oldprize47-SH/AutonomousDrone/complementary-filter/docs/Complementary_Filter.pptx

Complementary Filer Design

Autonomous Vehicle Control

School of Mechanical and Control Engineering
22000561 Jeayong Lee / 22100149 Yejoon Kim
22100652 Sein Jeon / 22300510 Dawon Lee

## Contents

1. 용어정리
2. 목표
3. 고도채널 안정화 루프 분석
4. 기압고도계 설계
5. 고도채널 안정화 루프 설계
6. 결과 분석
7. 부록

## 1. 목표

INS만을 활용하여 구한 자율이동체의
위치는 시간이 지남에 따라 발산

보조항법장치(Barometer 등)에서 구한 자율이동체의 위치는 정확하나 응답이 느림

보조항법 센서를 활용하여
INS의 발산하는 특성을 보완 하자!

## 2. 용어정리

Symbol | Name | Value
H_p | 기압고도 | 구해야 하는 값 [m]
H_0 | 해당 대기층 하단부의 기준 고도 | 0 [m]
T_0 | H_0 에서의 온도 | 288.15 [K]
P | 특정 고도에서의 기압 | 센서 측정 값 [Pa]
P_0 | H_0 에서의 기압 | 101325 [Pa]
R^(∗) | 보편 기체 상수(universal gas constant) | 8.13446 [J/(mol⋅K)]
Γ | 대류층 온도 변화율 | 0.0065 [K/m]
g_0 | 해수면 기준 중력 가속도 | 9.78032677 [m/s^2 ]
M | 공기의 평균 분자량 | 0.0289644 [kg/mol]
Z | 기하학적 고도 차이 | H_p −H_0 [m]
ρ | 공기 밀도 | 계산 값 [kg/m^3 ]
ρ_0 | H_0 에서의 공기 밀도 | 1.225 [kg/m^3 ]

**비고 - 지역에 따라서 달라질 가능성 有, 추후 파라미터 변경 가능

**비고

**비고

IMU 센서 출력 값 기준으로 변경

9.80665 [m/s^2 ]

높이의 증분( dZ )으로부터
정의 됨

**비고

*상수 값은 ICAO 표준규격 기준

## 3. 고도채널 안정화 루프 분석

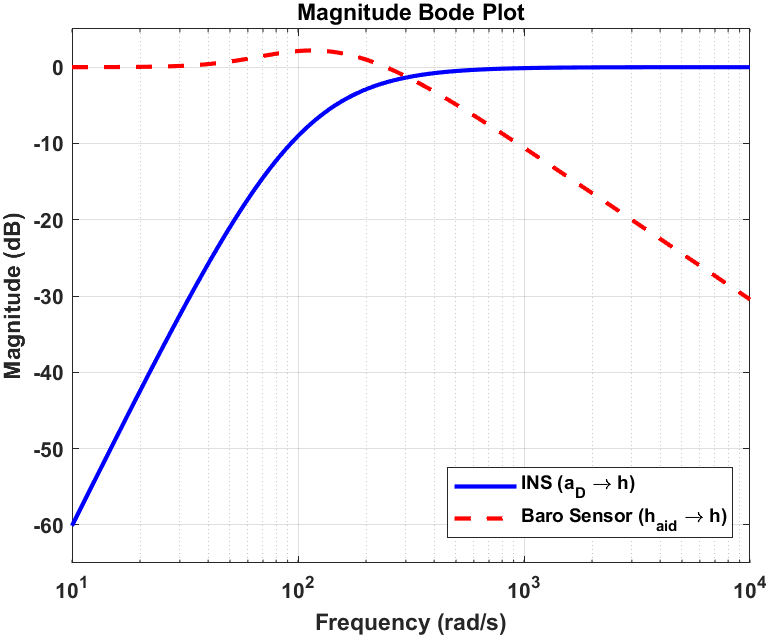
[picture p74: figure]

가속도계 ×1/s^2 ↦ 고도
(h⋅s^2)/(a_D)=(−s^3)/(S^3 +C_1 s^2 +(C_2 −2ω_s^2 )s+C_3)
보조센서 ↦ 고도
h/(h_(aid))=(C_1 s^2 +C_2 s+C_3)/(S^3 +C_1 s^2 +(C_2 −2ω_s^2 )s+C_3)

ω_c

ω_c =49.126 [Hz]

0.0203 [sec]

* τ=0.01 [sec] 기준

Q. 과연 유효한 값일까?

## 4. 기압고도계 설계 - 1

등온층유도 기본가정

(dP)/(dZ)=−ρg

ρ=(MP)/(R^(∗) T)

대기 정역학 방정식

dln(P)=−(g_0 M)/(R^(∗) T)dZ

위 식들을 결합하여,
온도, 기압, 고도의 관계로 정리

이상 기체 상태 방정식

## 4. 기압고도계 설계 - 2

등온층 가정식

(d(lnP))/(dZ)=−(g_0 M)/(R^(∗) T)

정역학 방정식을 lnP 로 미분

등온층 고도 계산 식

H_p =H_0 −(R^(∗) T_0)/(gM)ln(P/(P_0))

P=P_0 exp(−(g_0 M)/(R^(∗) T_0)Z)

등온층 지수형태 (압력)

ρ=ρ_0 exp(−(g_0 M)/(R^(∗) T_0)Z)

등온층 지수형태 (밀도)

그러나, 대류층에 속해 있으므로, 등온층 가정식이 성립하지 않음

등온층이 아닌 경우에 대해 수식이 필요

## 4. 기압고도계 설계 - 3

등온층이 아닌 경우 (고도에 따른 온도변화 식으로부터 유도)

고도에 따른 온도의 선형적 변화

T_0 (P/(P_0))^((R^(∗) Γ)/(g_0 M)) =T_0 −Γ(H_p −H_0 )

Γ(H_p −H_0 )=T_0 [1−(P/(P_0))^((R^(∗) Γ)/(g_0 M)) ]

T=T_0 −ΓZ

P=P_0 (T/(T_0))^((g_0 M)/(R^(∗) Γ))

온도 변화에 따른 기압변화

ρ=ρ_0 (T/(T_0))^((g_0 M)/(R^(∗) Γ)−1)

온도 변화에 따른 밀도변화

H_p =H_0 +(T_0)/Γ[1−(P/(P_0))^(−(R^(∗) Γ)/(g_0 M)) ]

최종 고도 계산 식

Γ=−(∂T)/(∂Z)

온도 감률
(고도변화에 따른 온도변화율)

## 4. 기압고도계 설계 – 4 (부록)

*진고도 기준 설정

두 값이 같으므로, Google Earth에서 제공하는 뉴턴홀의 고도를 참으로 가정하고 역산

‘기상청날씨루리’에서 제공하는 고도 값
‘Google Earth’의 고도 값

대한민국의 표준으로 가정
뉴턴홀의 고도 값을 받아올 수 있음

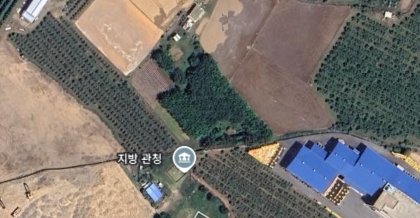
[picture p75: figure]

Google Earth 자료

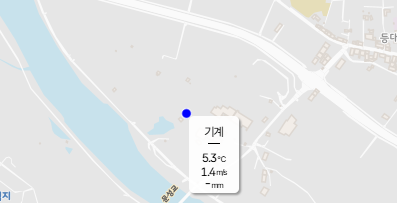
[picture p76: figure]

기상청날씨루리 자료

## 4. 기압고도계 설계 - 5

해면 기압 보정 값 계산 - 1

고도에 따른 온도변화 수식에서
T_0 에 대한 수식으로 변환하여 활용

T=T_0 −ΓZ

T_0 =T+ΓZ

P_0 =P((T_0)/T)^((g_0 M)/(R^(∗) Γ))

apply

P_0 =P(1+(ΓZ)/T)^((g_0 M)/(R^(∗) Γ))

## 4. 기압고도계 설계 - 6

해면 기압 보정 값 계산 - 2

- 측정 기압

P_1 =1015.53 [hPa]

P_0 =P_1 (1+(Γ⋅H_1)/(T_1))^((g_0 M)/(R^(∗) Γ))

- 측정 절대 온도

T_1 =294.9 [K]

- 진 고도

H_(true) =59 [m]

P_0 =1015.53×(1+(0.0065×59)/294.9)^5.2559

≈1022.49 [hPa]

## 4. 기압고도계 설계 - 7

보정된 해면기압 값을 활용한 고도 측정

- 보정된 해면 기압

P_0 =1022.49 [hPa]

H_p =H_0 +(T_0)/Γ[1−((P_2)/(P_0))^(−(R^(∗) Γ)/(g_0 M)) ]

- 측정 기압

P_2 =1015.53 [hPa]

- 측정 절대 온도

T_2 =295.38 [K]

H_2 =295.38/0.0065×[1−(1015.19/1022.49)^0.19026 ]

≈62.0 [m]

## 6. 결과 분석 – 기압고도계 설계

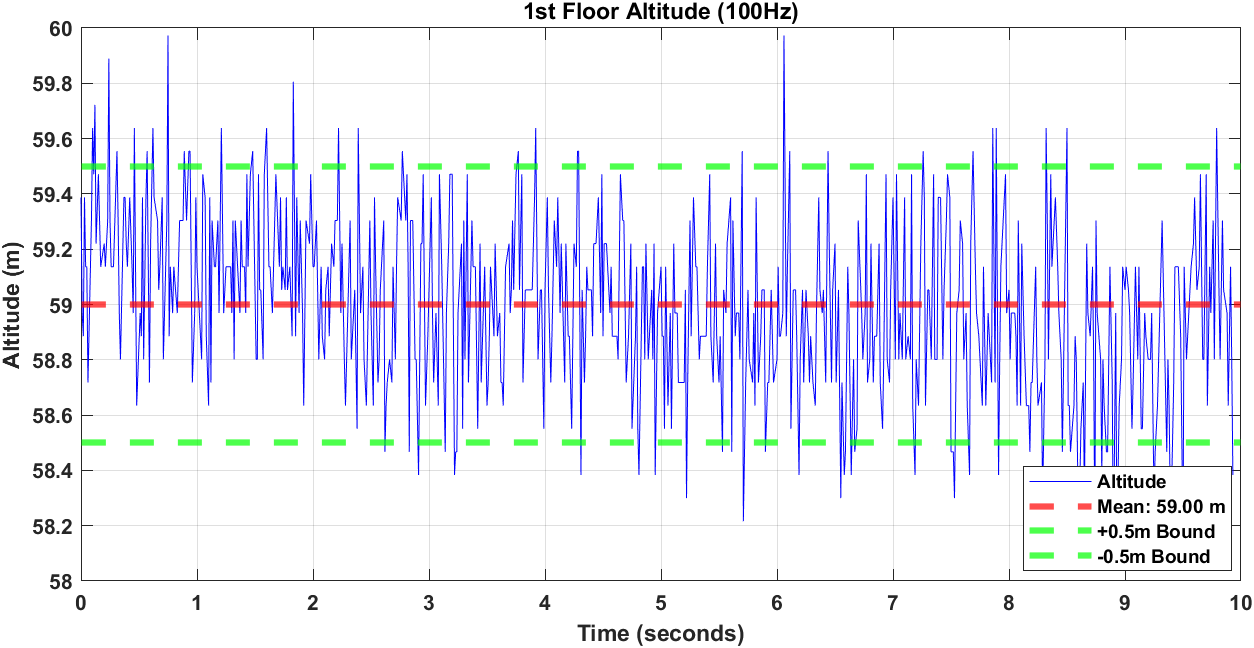
[picture p77: figure]

1층 고도 값 (100Hz)

Mean Value: 59.00 [m]

Sensor Resolution Boundary (±0.5 [m])

* 뉴턴홀 중앙 계단 기준 측정

## 6. 결과 분석 – 기압고도계 설계

* True Distance

H_(True)^12 =4.08 [m]

줄자를 활용하여 임시로 측정된 값

추후 레이저 거리측정기를 활용하여 정확한 거리 측정 필요

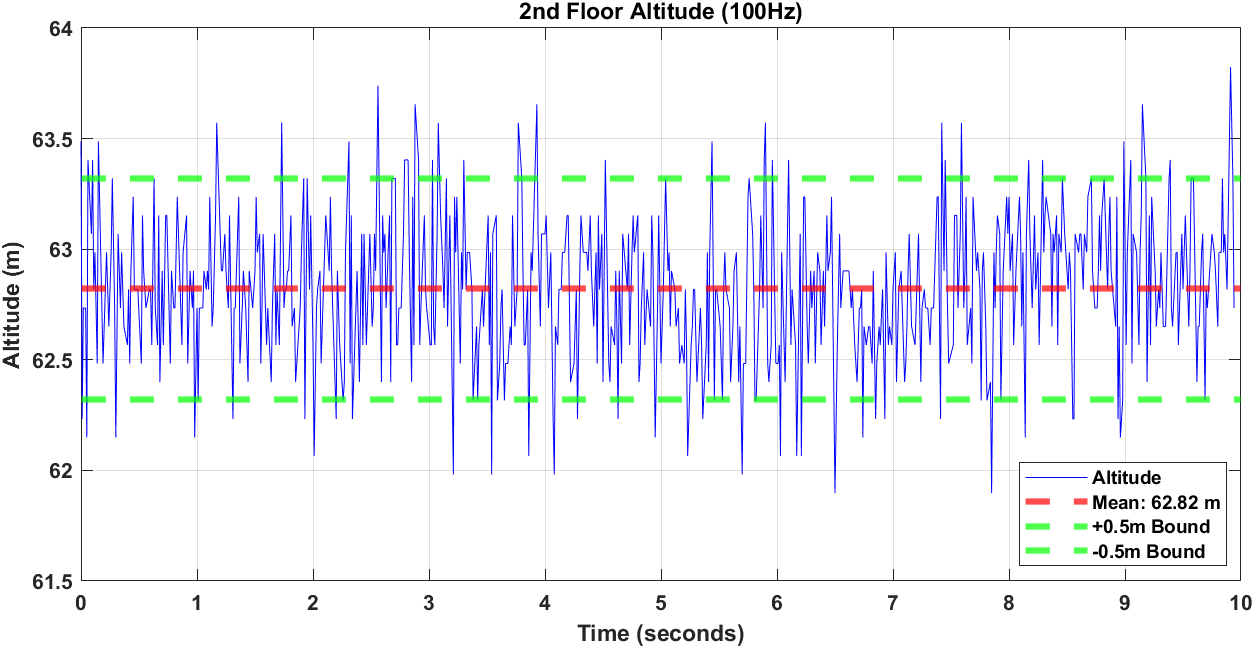
[picture p78: figure]

2층 고도 값 (100Hz)

Mean Value: 62.82 [m]

Sensor Resolution Boundary (±0.5 [m])

2nd Floor Altitude
H_2 =62.82 [m]

* 뉴턴홀 중앙 계단 기준 측정

1st Floor Altitude
H_1 =59.00 [m]

Sensor Distance
H_2 −H_1 =3.82 [m]

ΔH_(e2) =0.26 [m]

## 6. 결과 분석 – 기압고도계 설계

* True Distance

H_(True)^23 =3.4 [m]

줄자를 활용하여 임시로 측정된 값

추후 레이저 거리측정기를 활용하여 정확한 거리 측정 필요

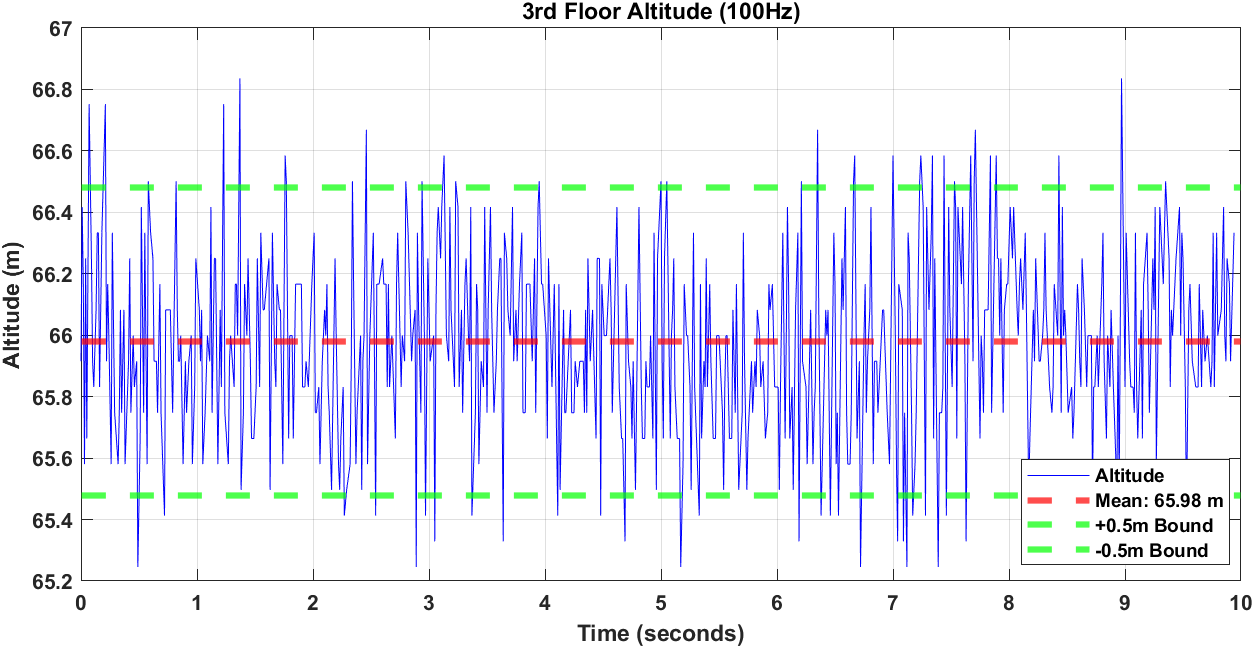
[picture p79: figure]

3층 고도 값 (100Hz)

Sensor Resolution Boundary (±0.5 [m])

Mean Value: 65.98 [m]

3rd Floor Altitude
H_3 =65.98 [m]

* 뉴턴홀 중앙 계단 기준 측정

2nd Floor Altitude
H_2 =62.82 [m]

Sensor Distance
H_3 −H_2 =3.16 [m]

ΔH_(e2) =0.24 [m]

## 6. 결과 분석 – 기압고도계 설계

matlab plot 창 넣야 함
- 센서 raw 데이터 (resolution 50cm 고려해서 이 안에 들어오는지 판단)
  - 기본 센서 데이터의 분산 정도? 나타내고 가면 좋을 듯 (제시된 resolutio의 신뢰성 판단용)
- 각 층별 고도 값 데이터 plot
  - 각 층별로 고도 값을 plot하고, 1층의 평균 데이터를 기준으로, 실제 측정고도(Z)값 만큼 더한 선들을 같이 plot 해서 나타내기
- 상대 고도 값 validation
- 실제 google earth (true value)값과 비교하면서 발생한 문제 언급

## 부록 1. 기압 데이터 측정 값 - 1층

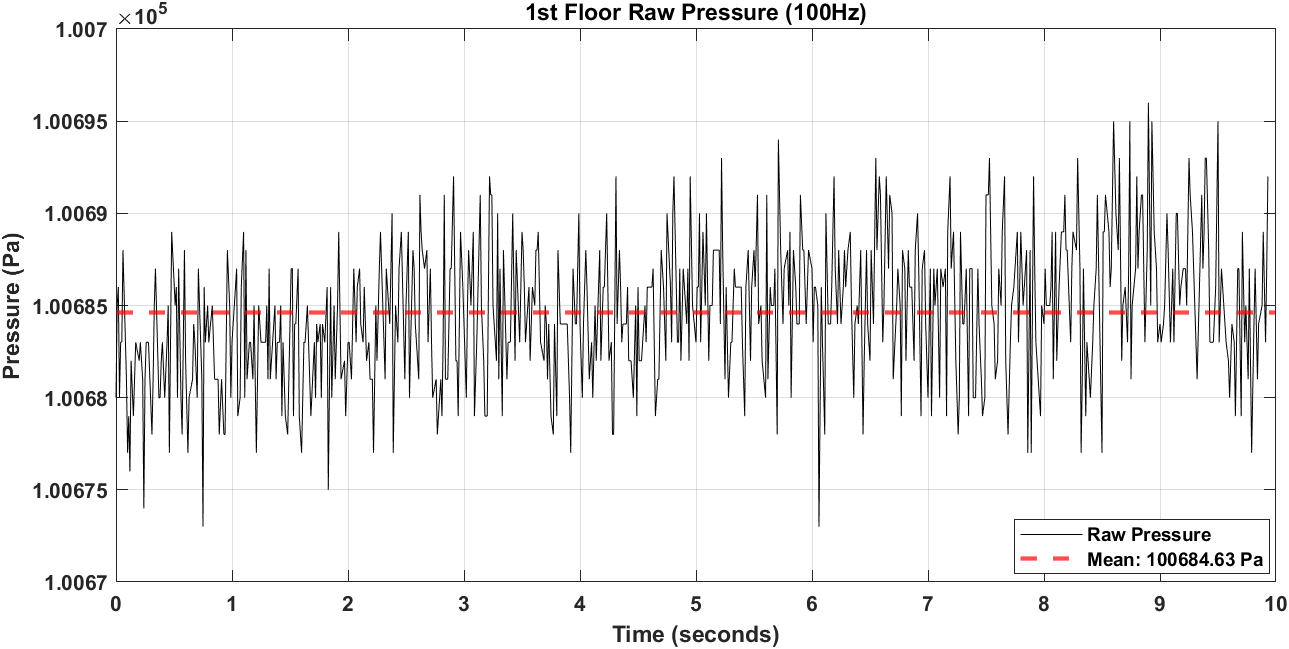
[picture p80: figure]

## 부록 1. 기압 데이터 측정 값 – 2층

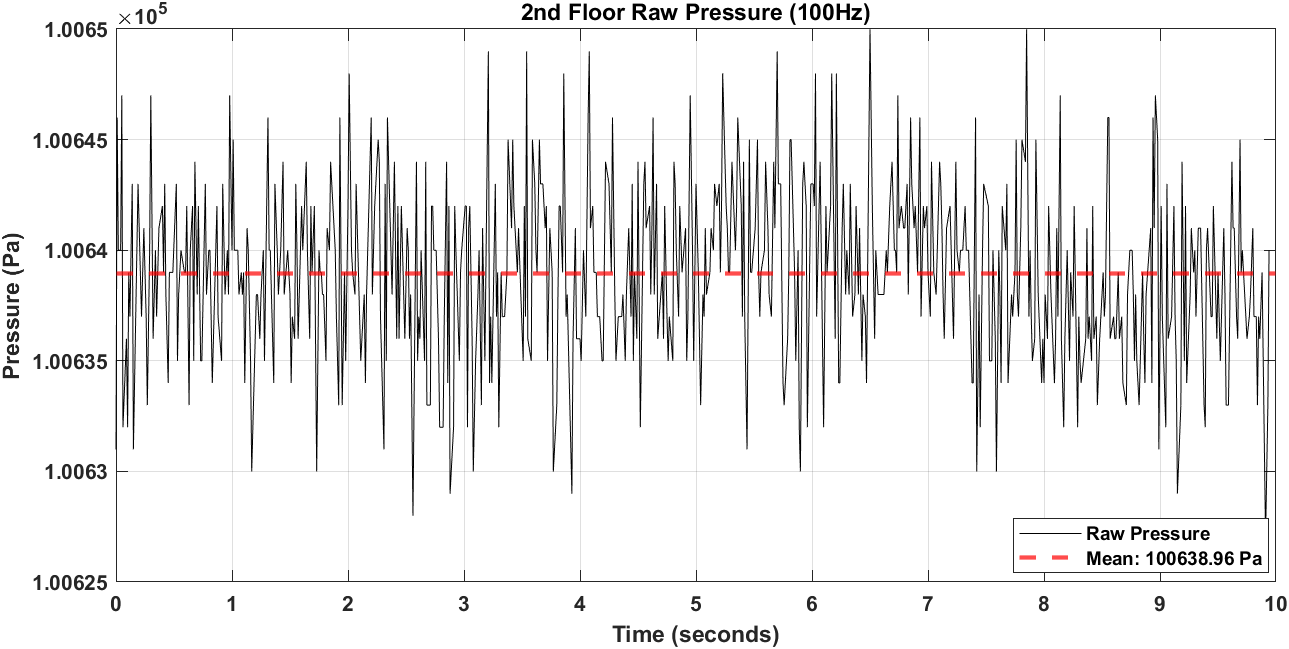
[picture p81: figure]

## 부록 1. 기압 데이터 측정 값 – 3층

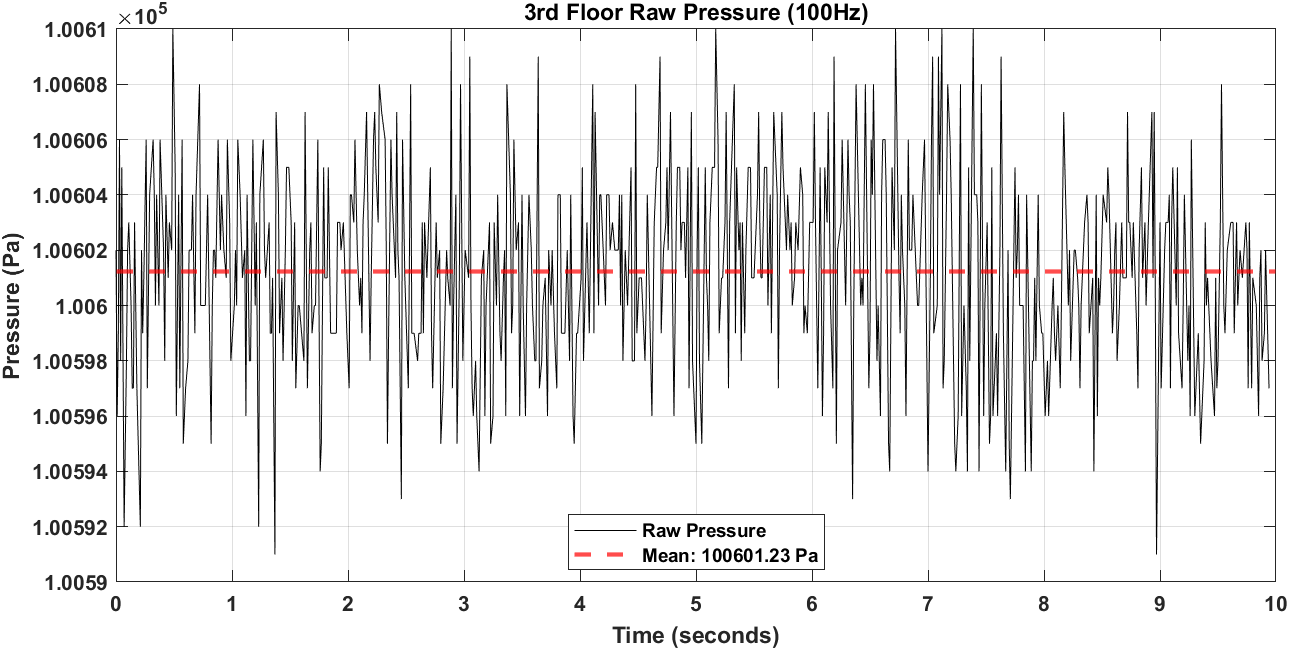
[picture p82: figure]
