oldprize47-SH/AutonomousDrone/assets/drone-photos/drone_field_02.jpg

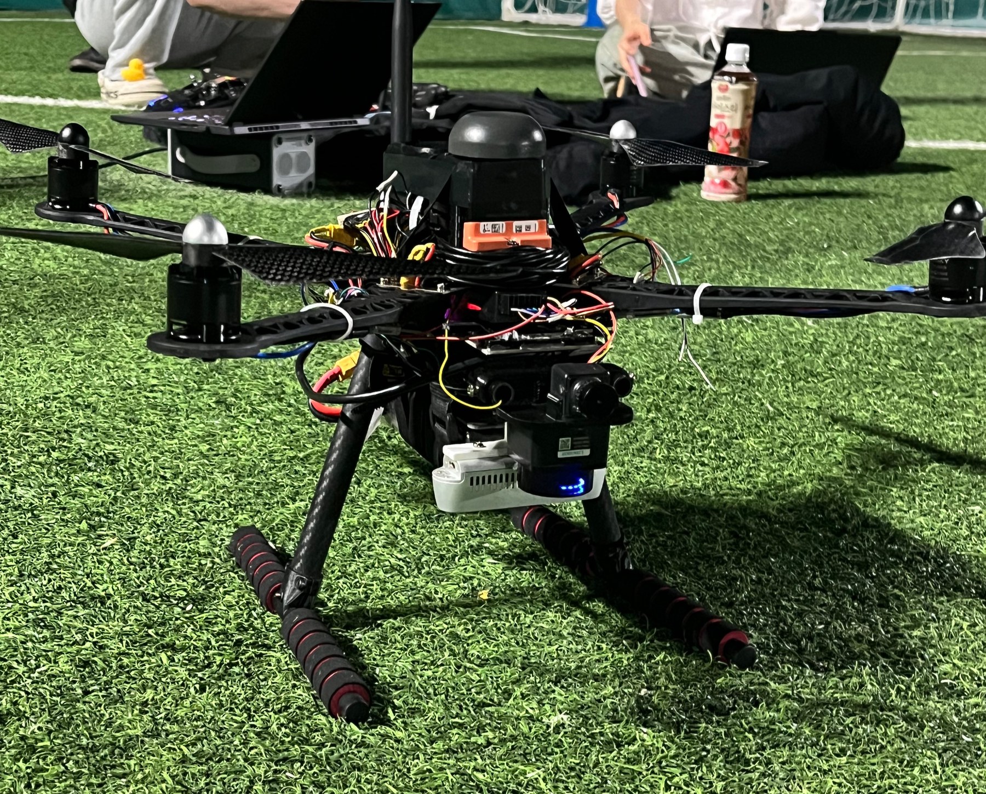
assets/drone-photos/drone_field_02.jpg
