oldprize47-SH/AutonomousDrone/assets/drone-photos/drone_field_03.jpg

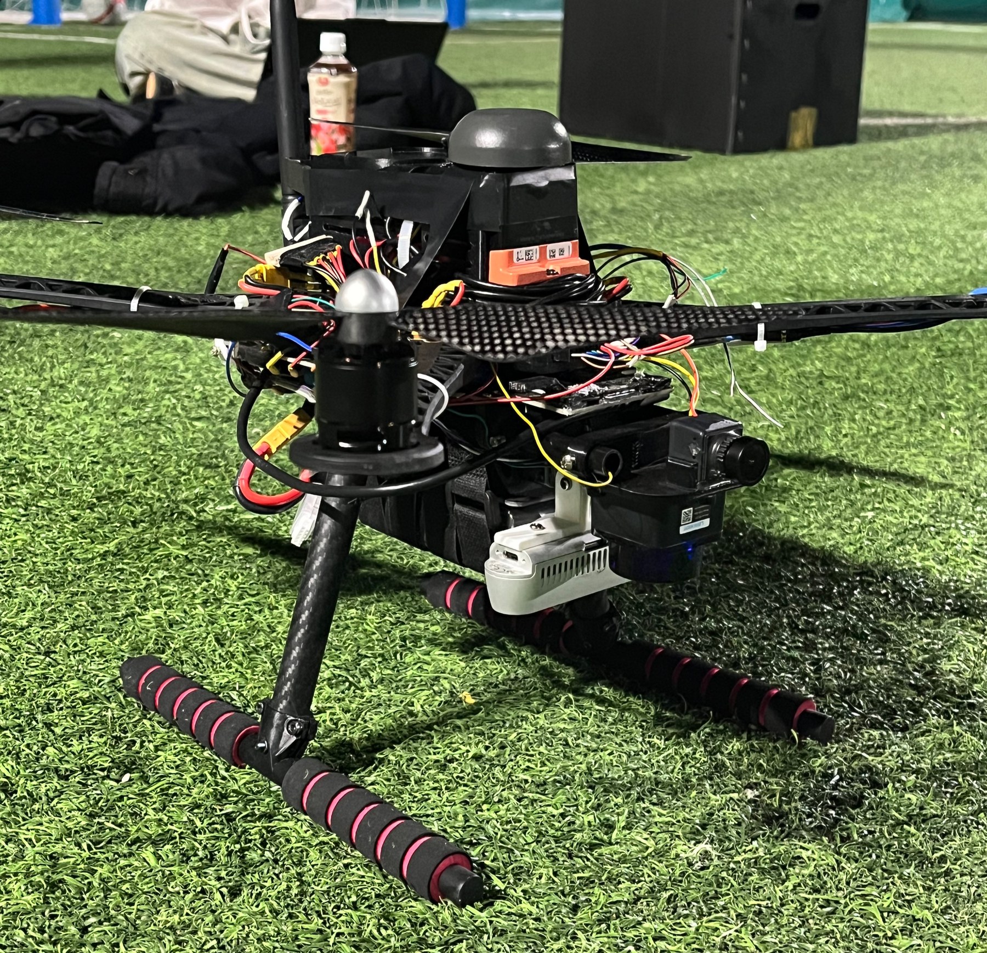
assets/drone-photos/drone_field_03.jpg
