oldprize47-SH/AutonomousDrone/development-report/experiment-results/position-guidance-control/png_relative_kinematics.png

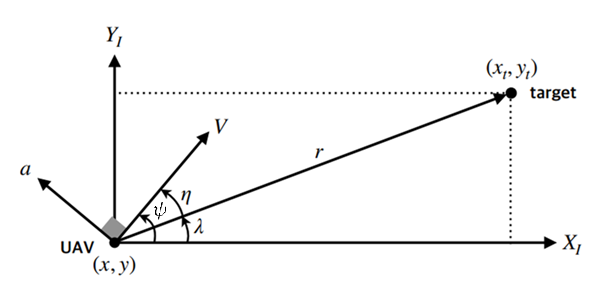
development-report/experiment-results/position-guidance-control/png_relative_kinematics.png
