oldprize47-SH/AutonomousDrone/development-report/system-architecture/GCS_Struc.png

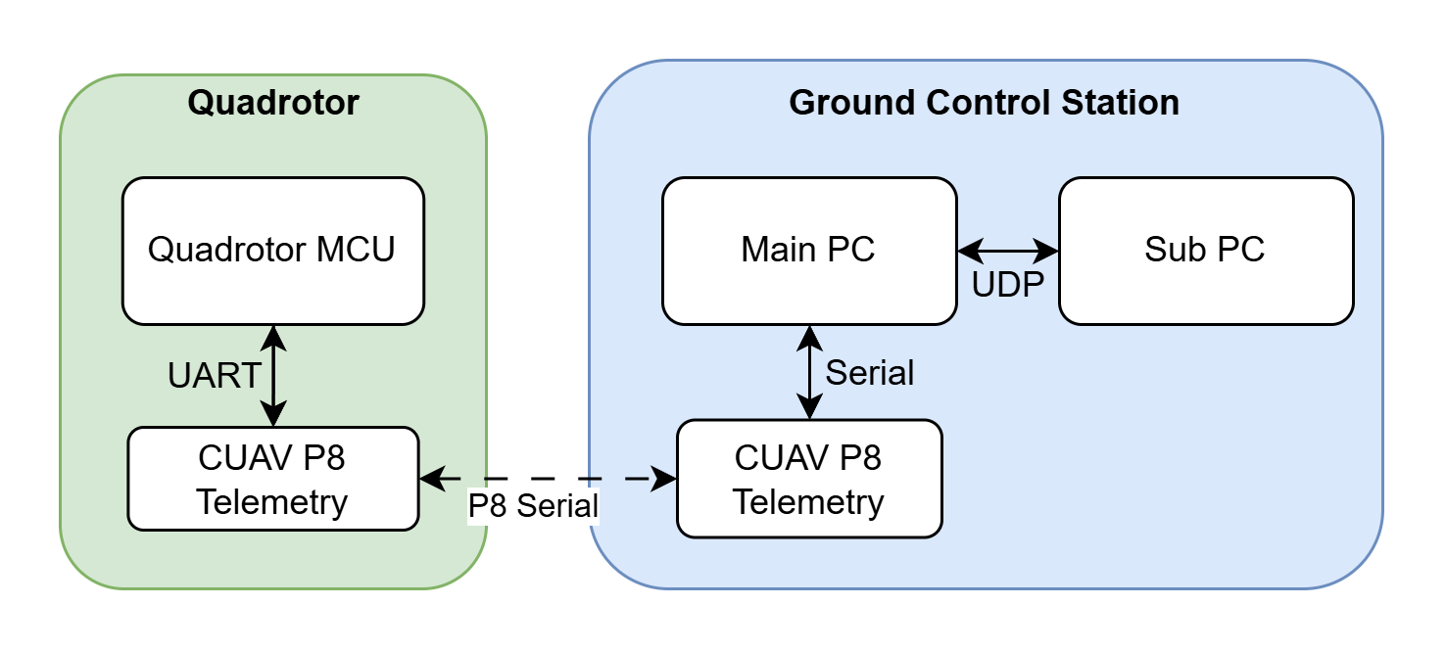
development-report/system-architecture/GCS_Struc.png
