oldprize47-SH/AutonomousDrone/development-report/system-architecture/HW_Diagram_1.png

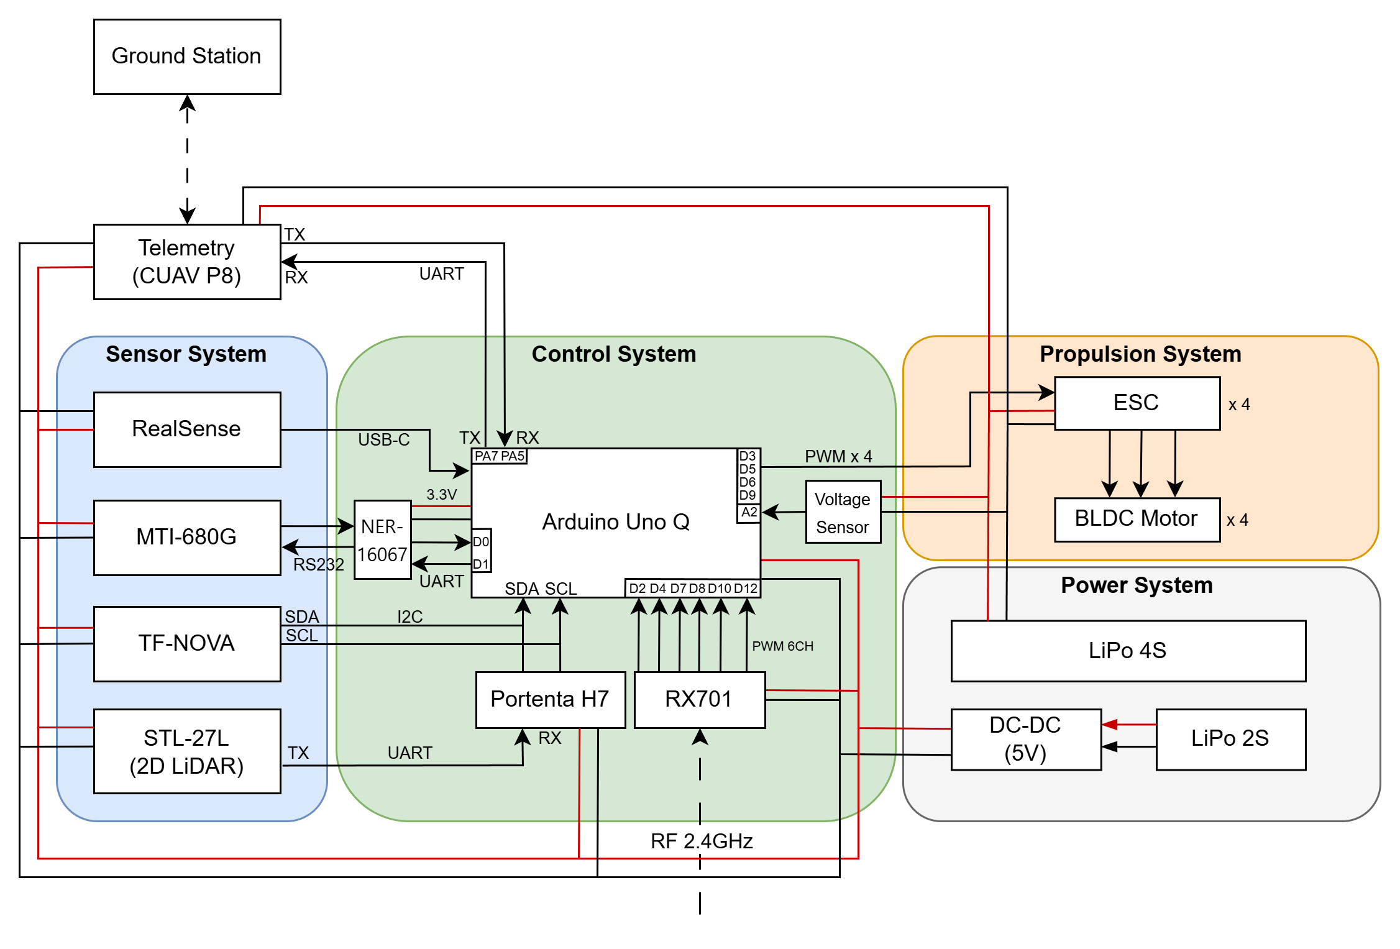
development-report/system-architecture/HW_Diagram_1.png
