oldprize47-SH/AutonomousDrone/development-report/system-architecture/rotational_inertia.png

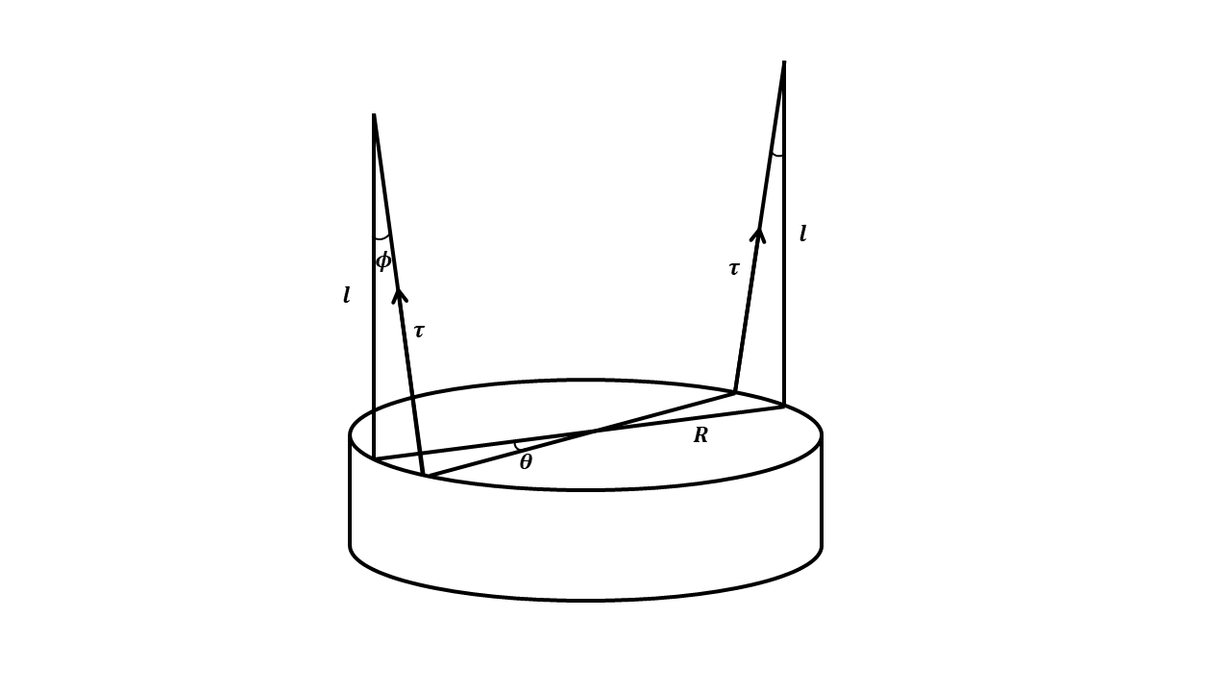
development-report/system-architecture/rotational_inertia.png
