oldprize47-SH/AutonomousDrone/docs/images/team-system-architecture.png

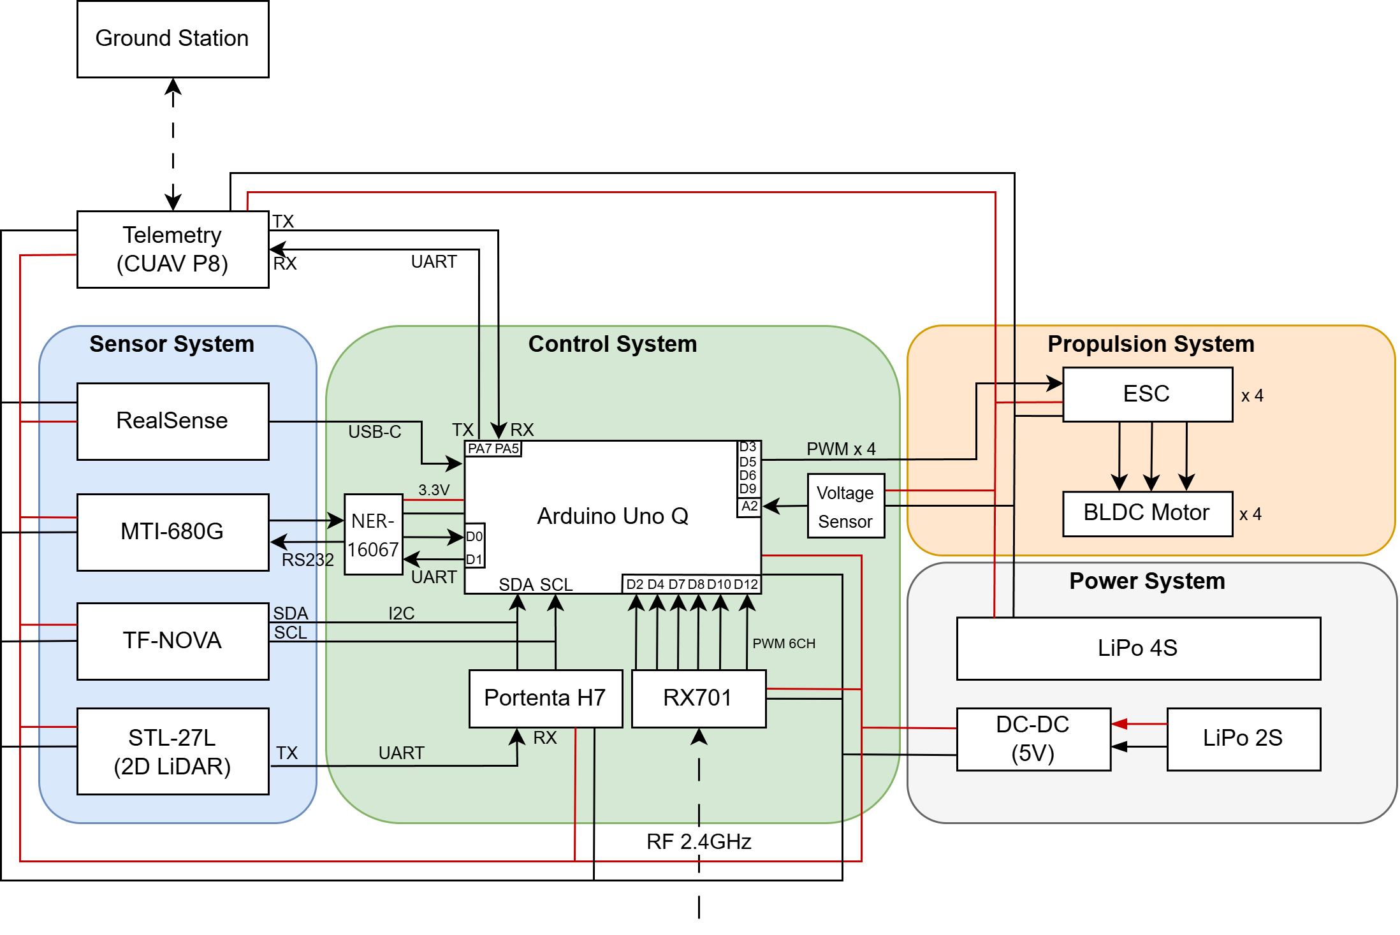
docs/images/team-system-architecture.png
