oldprize47-SH/AutonomousDrone/vision-system/docs/goals/project-focus-v1.png

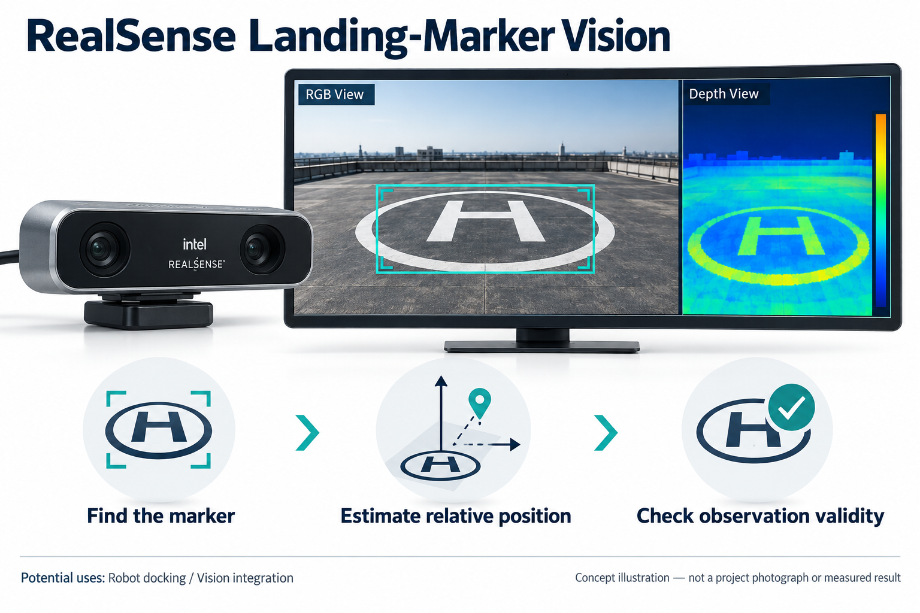
vision-system/docs/goals/project-focus-v1.png
