oldprize47-SH/AutonomousDrone/vision-system/docs/flight-evaluation-summary.md

# Recorded flight-evaluation summary

This is a bounded summary of the existing project-log analysis, not a new hardware test performed during portfolio migration.

## Evaluation rule

The labels were post-hoc operational categories for consistent analysis, not a predeclared official pass/fail requirement. They considered:

- whether a vision lock occurred during LAND/LAND_SLOW;
- last fresh-vision altitude and helipad residual;
- active horizontal-control error immediately before touchdown/state reset;
- time/altitude gap from the last fresh target to the final active control point.

## Result

Among six trials with a vision lock, only Final_7 was classified as **partial success / near**. Five trials were classified as precision-landing failures because fresh vision disappeared during descent or horizontal error remained.

Final_7 retained fresh vision to approximately 0.643 m altitude with about 0.113 m helipad residual, while the active controller still reported about 0.256 m horizontal error before touchdown. It therefore did not establish repeatable or complete precision landing.

## Engineering implication

A successful landing sequence is not sufficient evidence of vision-guided precision landing. Future validation must require fresh low-altitude vision and closed-loop horizontal convergence, and must reject stale target latches rather than allowing old measurements to stand in for current observations.
