oldprize47-SH/AutonomousDrone/development-report/experiment-results/position-guidance-control/Final_mission_validation_summary.csv

file | samples | duration_s | guidance_s | land_s | wp_count | max_wp_idx | max_rng_guidance_m | min_rng_guidance_m | final_dist_to_last_wp_m | max_alt_err_m | max_yaw_rate_err_dps | max_loop_dt_ms | rtk_fixed_pct | gnss_fix_pct | vlatch_seen | vision_used | obs_avoid_seen | states
Final_1.csv | 2163 | 198.405 | 43.182 | 8.86599999999999 | 6 | 5 | 9.68862 | 1.21408 | 8.69921633741799 | 2.99480954 | 76.6744153557765 | 327158 | 0 | 100 | 0 | 0 | 0 | GROUND->SPOOLUP->TAKEOFF->HOLD->GUIDANCE->LAND->LAND\_SLOW->SPOOLDOWN
Final_2.csv | 1572 | 87.34 | 41.388 | 7.70500000000001 | 6 | 5 | 9.12996 | 0.573675 | 7.61169431775213 | 2.99549527 | 90.347652066117 | 18.736 | 100 | 100 | 1 | 1 | 0 | GROUND->SPOOLUP->TAKEOFF->HOLD->GUIDANCE->LAND->LAND\_SLOW->SPOOLDOWN->DISARMED
Final_3.csv | 1244 | 69.056 | 40.565 | 7.58599999999996 | 6 | 5 | 9.53404 | 1.28232 | 6.85803938093826 | 3.00241212 | 54.3962692950433 | 18371.2 | 100 | 100 | 1 | 1 | 0 | GROUND->SPOOLUP->TAKEOFF->HOLD->GUIDANCE->LAND->LAND\_SLOW->SPOOLDOWN->DISARMED
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
