oldprize47-SH/AutonomousDrone/complementary-filter/data-samples/260327_filter_test_linear.txt

Elapsed	Pressure	Baro_Alt	Filtered_Alt	Velocity
5.0300	100971	59.4518	59.0011	0.0003
5.0400	100977	58.9513	59.0021	0.0007
5.0500	100969	59.6186	59.0036	0.0011
5.0600	100974	59.2015	59.0056	0.0016
5.0700	100973	59.2850	59.0068	0.0020
5.0800	100981	58.6176	59.0066	0.0022
5.0900	100978	58.8679	59.0053	0.0022
5.1000	100979	58.7844	59.0044	0.0022
5.1100	100973	59.2850	59.0045	0.0025
5.1200	100978	58.8679	59.0049	0.0028
5.1300	100988	58.0337	59.0022	0.0025
5.1400	100972	59.3684	59.0007	0.0023
5.1500	100977	58.9513	59.0015	0.0025
5.1600	100975	59.1181	59.0017	0.0026
5.1700	100981	58.6176	59.0011	0.0027
5.1800	100977	58.9513	59.0000	0.0028
5.1900	100977	58.9513	58.9998	0.0030
5.2000	100973	59.2850	59.0004	0.0032
5.2100	100977	58.9513	59.0010	0.0034
5.2200	100977	58.9513	59.0008	0.0035
5.2300	100979	58.7844	59.0002	0.0035
5.2400	100979	58.7844	58.9991	0.0035
5.2500	100978	58.8679	58.9983	0.0036
5.2600	100973	59.2850	58.9987	0.0039
5.2700	100973	59.2850	59.0002	0.0045
5.2800	100974	59.2015	59.0015	0.0050
5.2900	100973	59.2850	59.0027	0.0054
5.3000	100975	59.1181	59.0038	0.0058
5.3100	100975	59.1181	59.0044	0.0060
5.3200	100977	58.9513	59.0046	0.0062
5.3300	100977	58.9513	59.0044	0.0064
5.3400	100984	58.3674	59.0027	0.0062
5.3500	100977	58.9513	59.0011	0.0061
5.3600	100979	58.7844	59.0005	0.0063
5.3700	100977	58.9513	58.9999	0.0065
5.3800	100977	58.9513	58.9997	0.0067
5.3900	100975	59.1181	58.9999	0.0068
5.4000	100973	59.2850	59.0010	0.0072
5.4100	100978	58.8679	59.0015	0.0074
5.4200	100982	58.5342	59.0000	0.0074
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
