oldprize47-SH/AutonomousDrone/complementary-filter/data-samples/260327_filter_test_nonlinear.txt

Elapsed	Pressure	Baro_Alt	Filtered_Alt	Velocity
5.0300	100971	59.2503	59.0006	0.0001
5.0400	100971	59.2503	59.0019	0.0003
5.0500	100977	58.7497	59.0019	0.0002
5.0600	100969	59.4171	59.0023	0.0003
5.0700	100980	58.4995	59.0021	0.0004
5.0800	100970	59.3337	59.0016	0.0004
5.0900	100970	59.3337	59.0033	0.0007
5.1000	100975	58.9166	59.0039	0.0008
5.1100	100970	59.3337	59.0045	0.0009
5.1200	100981	58.4161	59.0039	0.0008
5.1300	100969	59.4171	59.0035	0.0008
5.1400	100970	59.3337	59.0053	0.0012
5.1500	100981	58.4161	59.0047	0.0012
5.1600	100977	58.7497	59.0026	0.0010
5.1700	100970	59.3337	59.0028	0.0011
5.1800	100971	59.2503	59.0043	0.0013
5.1900	100971	59.2503	59.0055	0.0014
5.2000	100974	59.0000	59.0061	0.0014
5.2100	100975	58.9166	59.0059	0.0013
5.2200	100971	59.2503	59.0063	0.0013
5.2300	100977	58.7497	59.0063	0.0014
5.2400	100977	58.7497	59.0050	0.0013
5.2500	100975	58.9166	59.0042	0.0013
5.2600	100966	59.6674	59.0056	0.0016
5.2700	100975	58.9166	59.0071	0.0019
5.2800	100975	58.9166	59.0066	0.0018
5.2900	100980	58.4995	59.0052	0.0016
5.3000	100978	58.6663	59.0031	0.0012
5.3100	100970	59.3337	59.0030	0.0010
5.3200	100970	59.3337	59.0047	0.0014
5.3300	100974	59.0000	59.0055	0.0016
5.3400	100979	58.5829	59.0045	0.0015
5.3500	100979	58.5829	59.0024	0.0010
5.3600	100970	59.3337	59.0022	0.0009
5.3700	100971	59.2503	59.0036	0.0011
5.3800	100975	58.9166	59.0040	0.0011
5.3900	100978	58.6663	59.0030	0.0010
5.4000	100974	59.0000	59.0022	0.0010
5.4100	100971	59.2503	59.0028	0.0010
5.4200	100972	59.1668	59.0038	0.0012
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
