oldprize47-SH/AutonomousDrone/complementary-filter/data-samples/filter_result_2.txt

Time	Raw_Alt	Filtered_Alt
0.0102	58.9468	59.0000
0.0206	59.0299	59.0000
0.0313	59.4459	59.0000
0.0412	59.1963	59.0000
0.0512	58.6972	59.0000
0.0613	58.8636	59.0000
0.0712	59.1963	59.0000
0.0813	59.1131	59.0001
0.0913	58.5308	59.0001
0.1012	58.8636	59.0001
0.1112	59.1131	59.0001
0.1213	59.1131	59.0001
0.1312	59.1131	59.0001
0.1413	58.6140	59.0002
0.1513	58.7804	59.0002
0.1612	58.5308	59.0002
0.1713	59.1131	59.0002
0.1812	58.9468	59.0003
0.1912	59.1963	59.0003
0.2013	59.1963	59.0003
0.2114	58.9468	59.0004
0.2212	59.4459	59.0004
0.2314	59.0299	59.0005
0.2413	59.1131	59.0005
0.2513	58.5308	59.0006
0.2612	58.5308	59.0006
0.2712	59.3627	59.0007
0.2812	59.1131	59.0007
0.2912	58.8636	59.0008
0.3012	59.1131	59.0008
0.3112	59.5291	59.0009
0.3212	58.9468	59.0009
0.3312	59.3627	59.0010
0.3412	58.7804	59.0011
0.3512	58.8636	59.0011
0.3603	58.7804	59.0012
0.3713	59.2795	59.0013
0.3814	59.1963	59.0013
0.3913	58.4476	59.0014
0.4014	59.5291	59.0015
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
