oldprize47-SH/AutonomousDrone/ground-control-station/WayPoint/POS_test_2_5WP.txt

# mission from subPC 2026-06-14 00:08:41 (lat lon, decimal deg)
36.1023178 129.3875732
36.1023483 129.3876342
36.1022491 129.3875885
36.1022796 129.3874969
36.1023750 129.3875579
36.1023216 129.3875732
