oldprize47-SH/AutonomousDrone/development-report/experiment-results/vision-landing/Final_vision_landing_summary.csv

file | samples | duration_s | landing_s | fresh_helipad_seen | vlatch_seen | vision_used | fresh_samples_in_land | reject_samples_in_land | vision_use_s | first_latch_t_s | first_use_t_s | max_raw_xy_land_m | final_raw_xy_m | max_abs_raw_x_land_m | max_abs_raw_y_land_m | max_dcm_offset_m | latch_move_m | final_pos_to_latch_m | min_land_pos_to_latch_m | final_lidar_alt_m | final_h_used_m
Final_2.csv | 1572 | 87.34 | 7.70500000000001 | 1 | 1 | 1 | 16 | 0 | 5.53 | 74.321 | 74.321 | 1.008 | 0.46 | 0.998 | 0.389 | 1.00775428300752 | 0.662436800004348 | 8.73756772378332 | 0.274126635882031 | 0.00999729 | 0.00477962
Final_3.csv | 1244 | 69.056 | 7.58599999999996 | 1 | 1 | 1 | 13 | 0 | 5.488 | 58.275 | 58.275 | 0.976 | 0.384 | 0.975 | 0.27 | 0.958163924083974 | 0.507854107101636 | 7.97969215181262 | 0.228848591212618 | -1.48958e-08 | 0.00699779
Final_5.csv | 1170 | 64.9469999999999 | 6.89400000000001 | 1 | 1 | 1 | 24 | 0 | 4.77499999999998 | 54.878 | 54.878 | 0.391 | 0.336 | 0.379 | 0.381 | 0.390223011666406 | 0.488584997723017 | 8.46944300866356 | 0.186388036096741 | 0.00999721 | 0.0102144
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
