oldprize47-SH/AutonomousDrone/development-report/experiment-results/altitude-control/altitude_controller_outputs.png

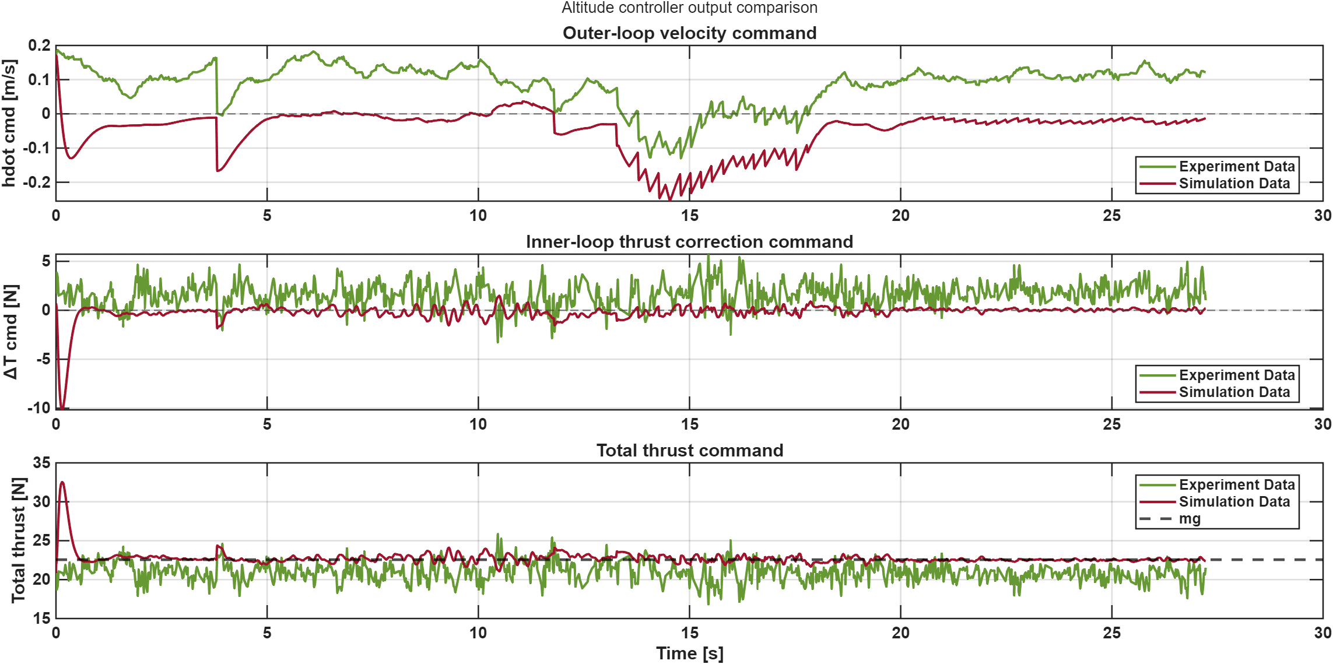
development-report/experiment-results/altitude-control/altitude_controller_outputs.png
