oldprize47-SH/AutonomousDrone/development-report/experiment-results/attitude-control/pitch_rate_response_and_torque.png

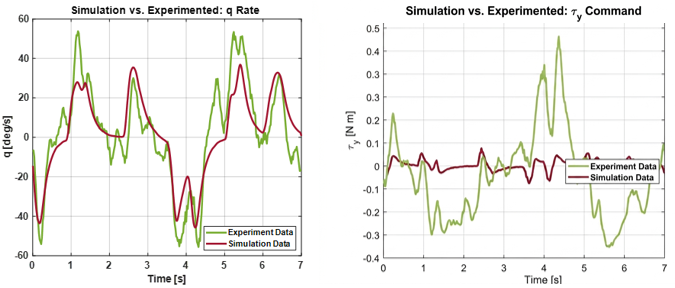
development-report/experiment-results/attitude-control/pitch_rate_response_and_torque.png
