oldprize47-SH/AutonomousDrone/development-report/experiment-results/gcs-monitoring/sub_station_dashboard_1.png

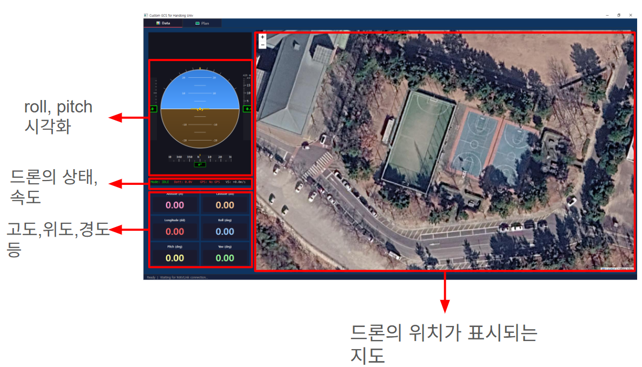
development-report/experiment-results/gcs-monitoring/sub_station_dashboard_1.png
