oldprize47-SH/AutonomousDrone/development-report/experiment-results/gcs-monitoring/sub_station_dashboard_2.png

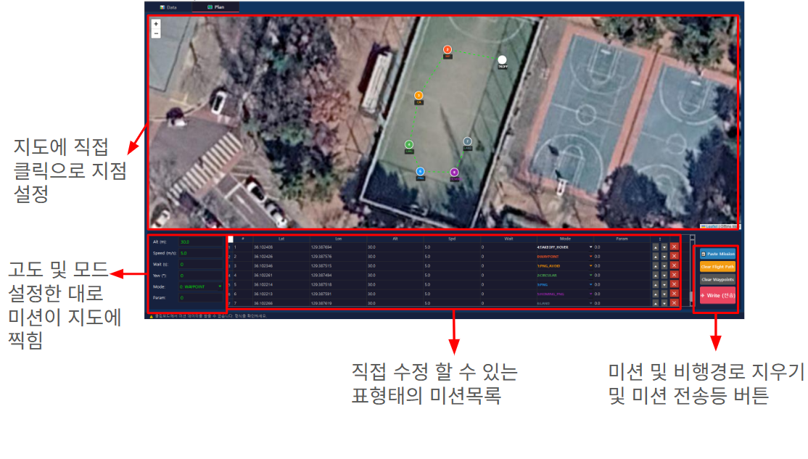
development-report/experiment-results/gcs-monitoring/sub_station_dashboard_2.png
