oldprize47-SH/AutonomousDrone/development-report/experiment-results/position-guidance-control/circular_guidance_path.png

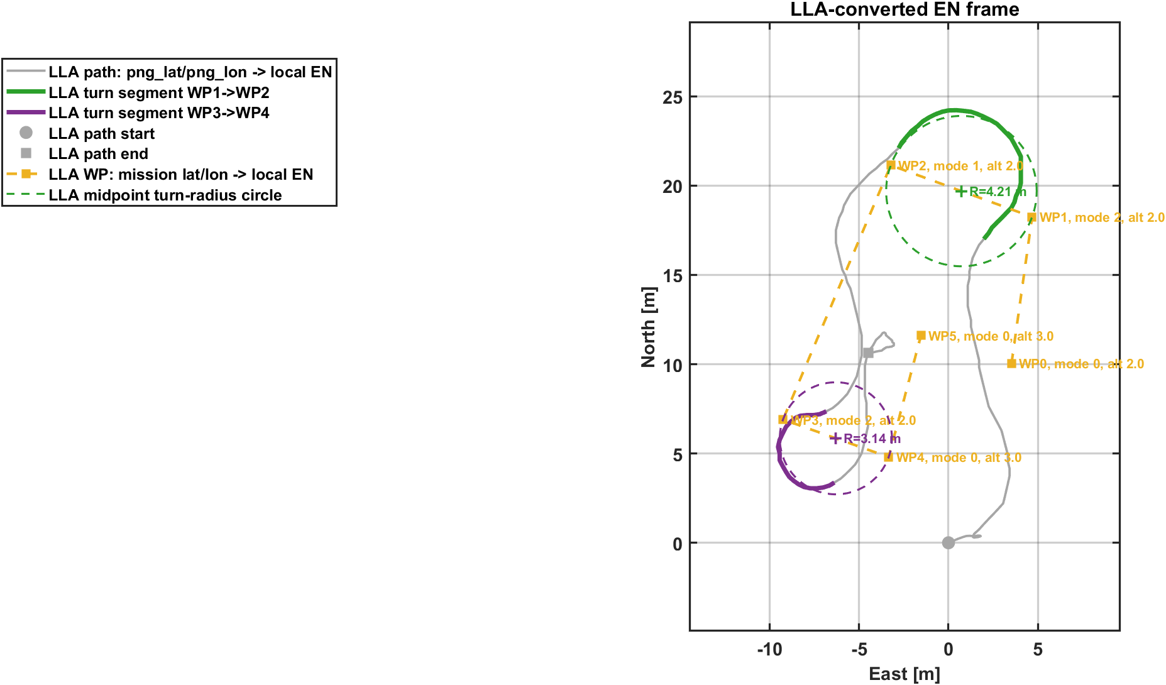
development-report/experiment-results/position-guidance-control/circular_guidance_path.png
