oldprize47-SH/AutonomousDrone/development-report/experiment-results/position-guidance-control/circular_mission_turns.png

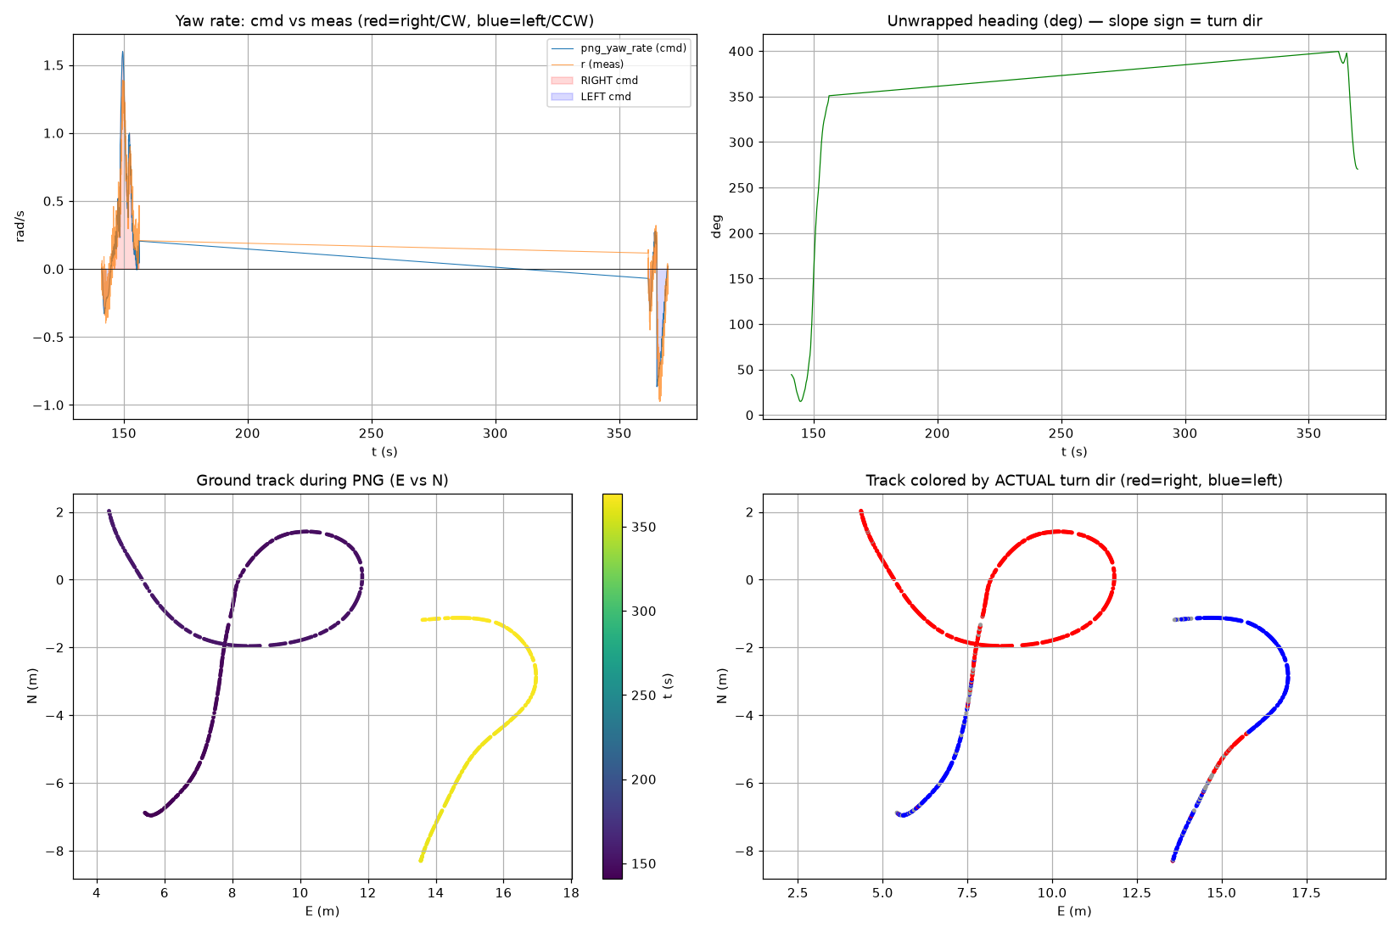
development-report/experiment-results/position-guidance-control/circular_mission_turns.png
