oldprize47-SH/AutonomousDrone/development-report/experiment-results/position-guidance-control/png_onset_1.png

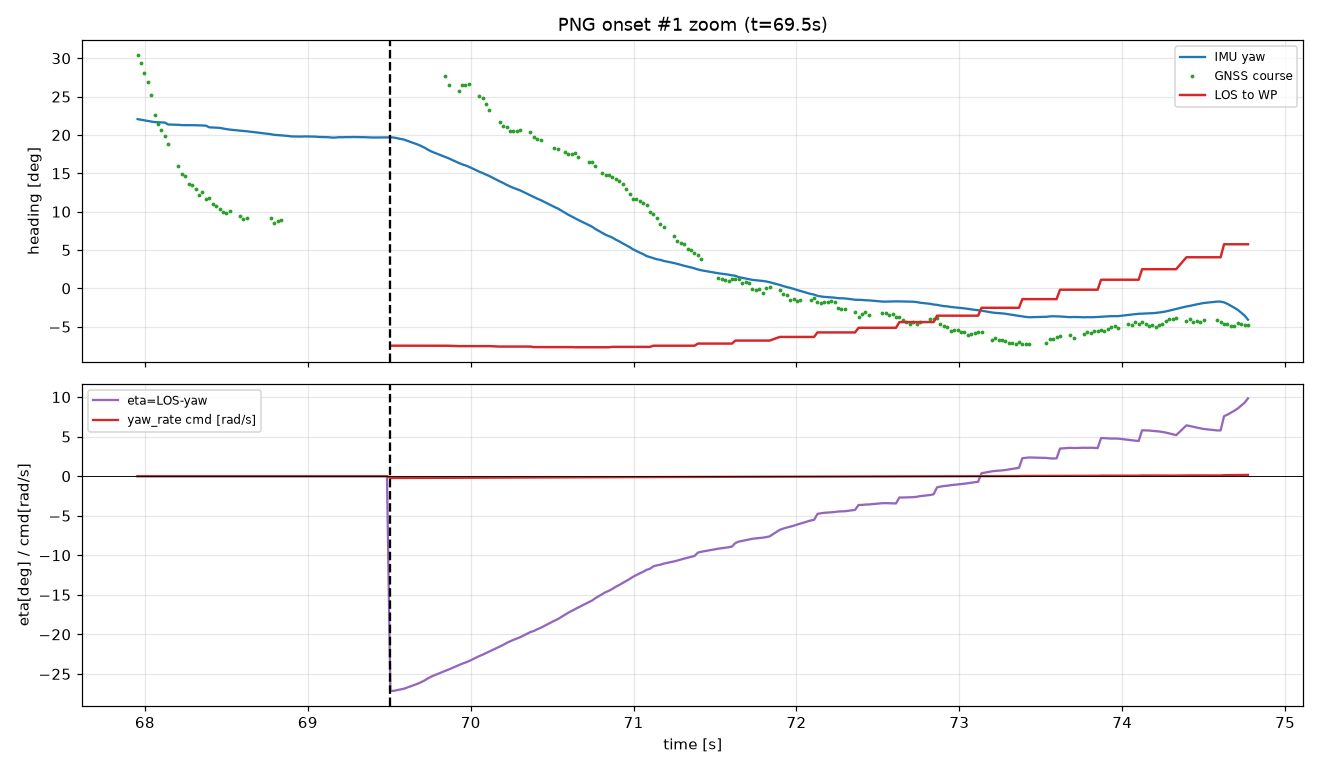
development-report/experiment-results/position-guidance-control/png_onset_1.png
