oldprize47-SH/AutonomousDrone/development-report/experiment-results/position-guidance-control/png_onset_2.png

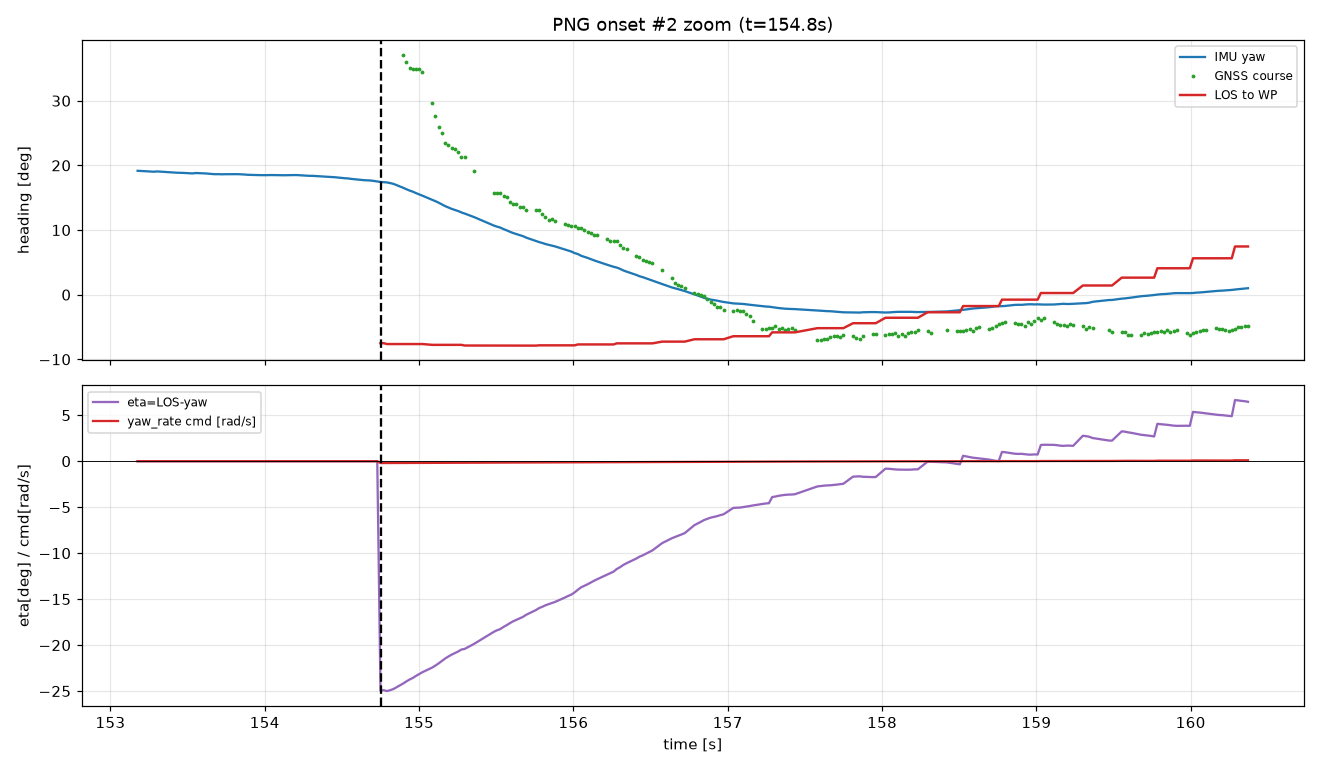
development-report/experiment-results/position-guidance-control/png_onset_2.png
