oldprize47-SH/AutonomousDrone/development-report/experiment-results/position-guidance-control/png_summary.png

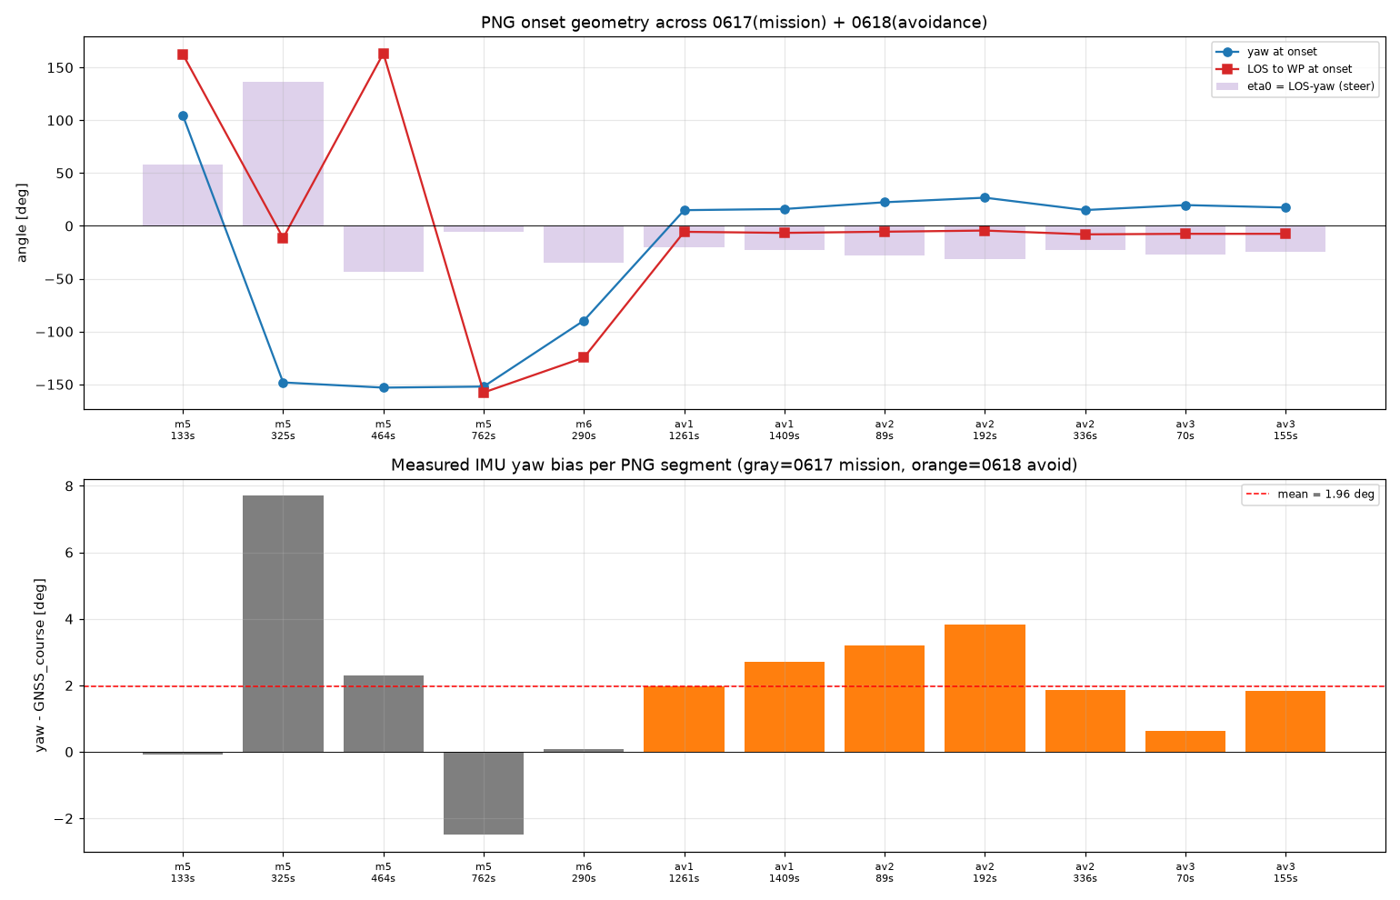
development-report/experiment-results/position-guidance-control/png_summary.png
