oldprize47-SH/AutonomousDrone/development-report/experiment-results/position-guidance-control/yaw_side_0617m5.png

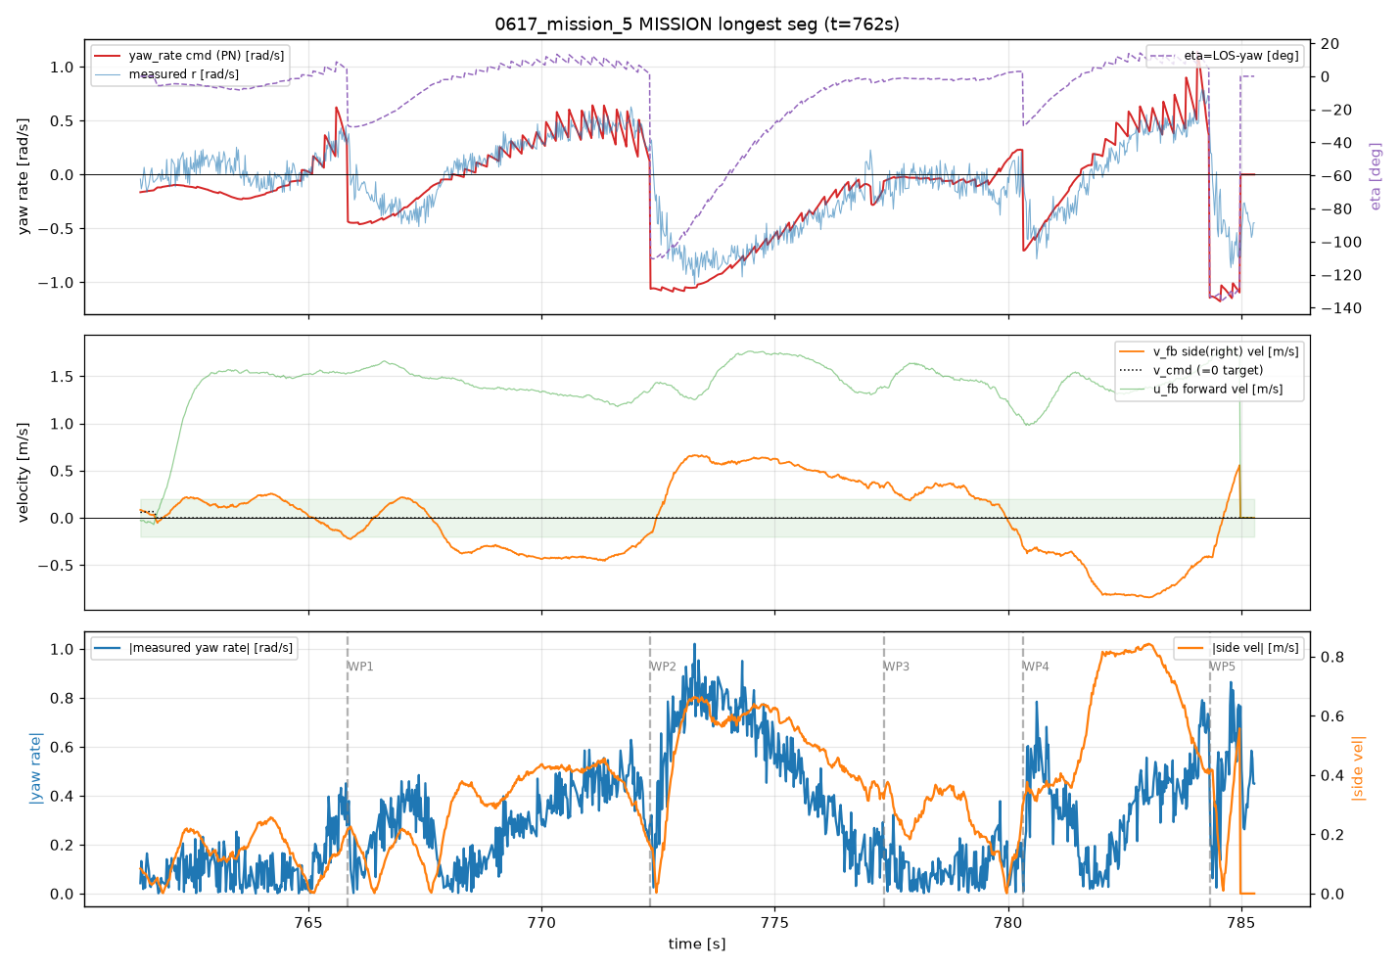
development-report/experiment-results/position-guidance-control/yaw_side_0617m5.png
