oldprize47-SH/AutonomousDrone/development-report/experiment-results/position-guidance-control/yaw_side_0617m6.png

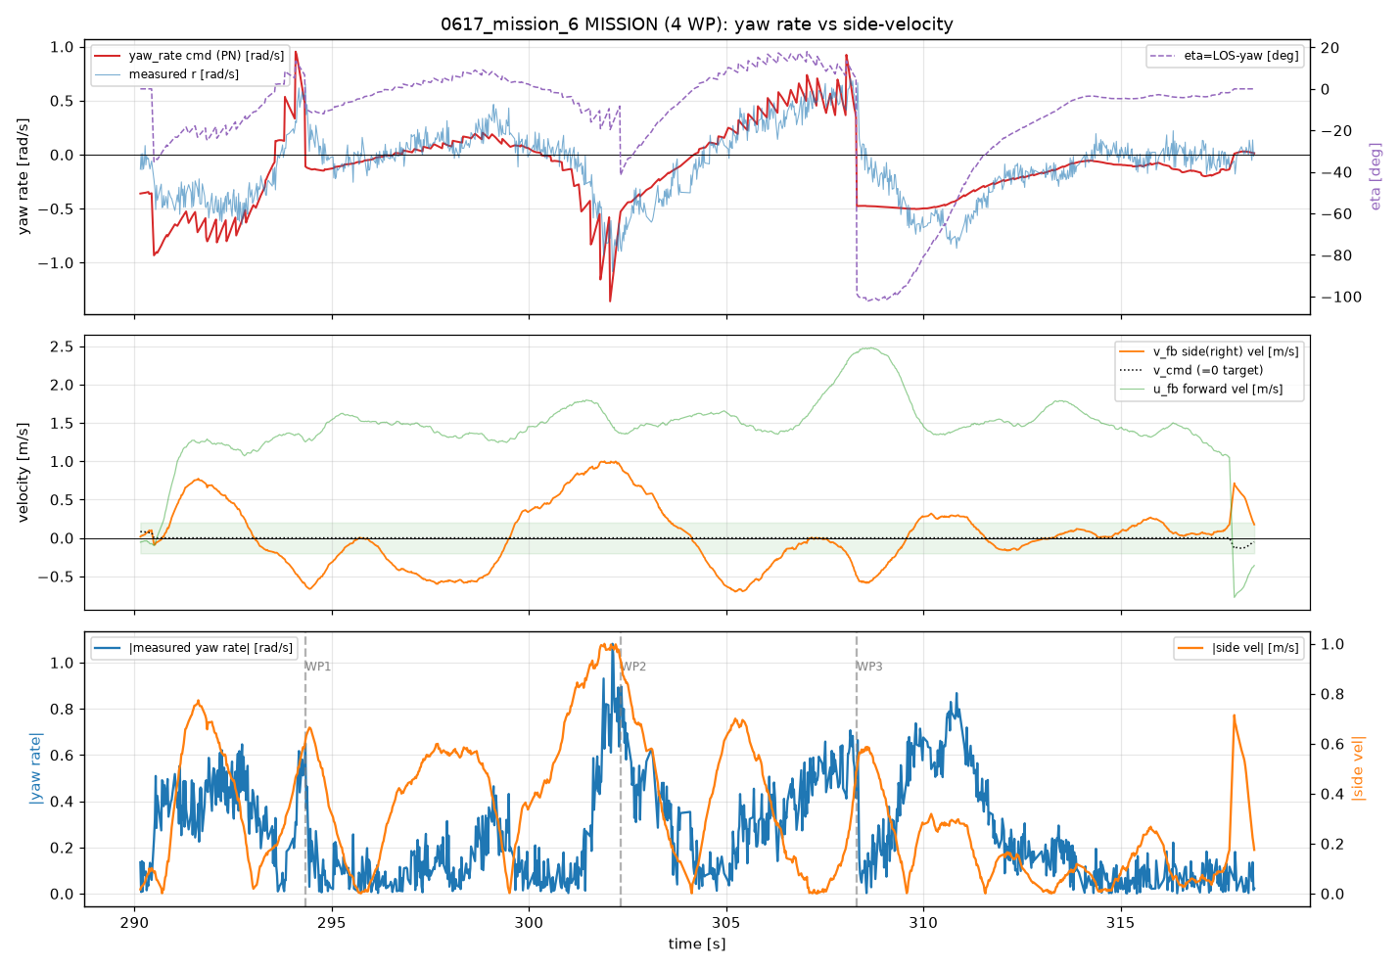
development-report/experiment-results/position-guidance-control/yaw_side_0617m6.png
