oldprize47-SH/AutonomousDrone/development-report/experiment-results/position-guidance-control/yaw_side_0618av3_seg1.png

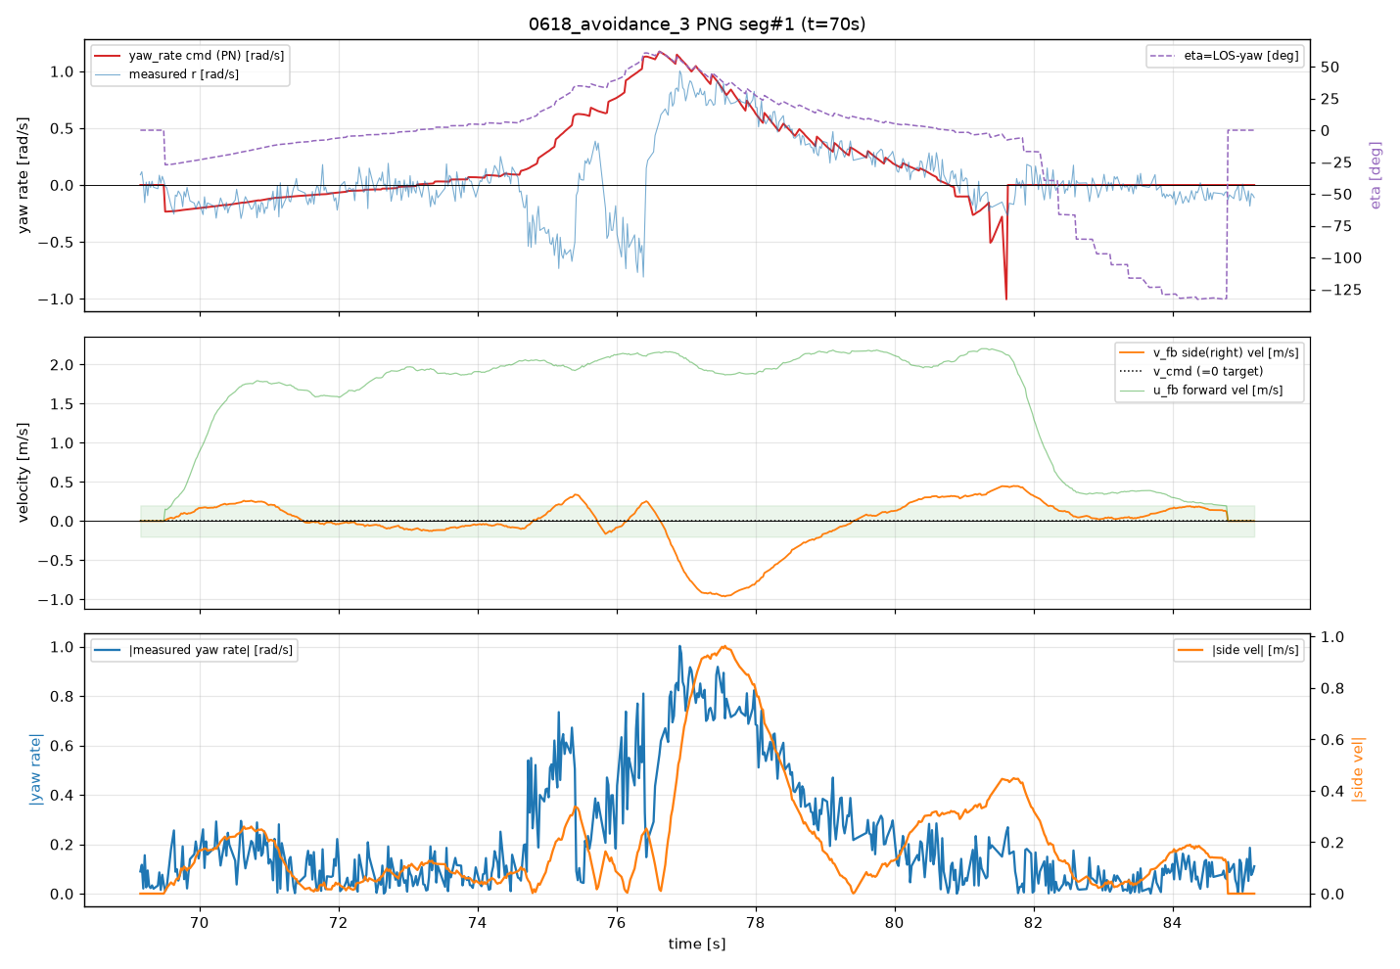
development-report/experiment-results/position-guidance-control/yaw_side_0618av3_seg1.png
