oldprize47-SH/AutonomousDrone/development-report/experiment-results/vision-landing/helipad_detection_examples.jpeg

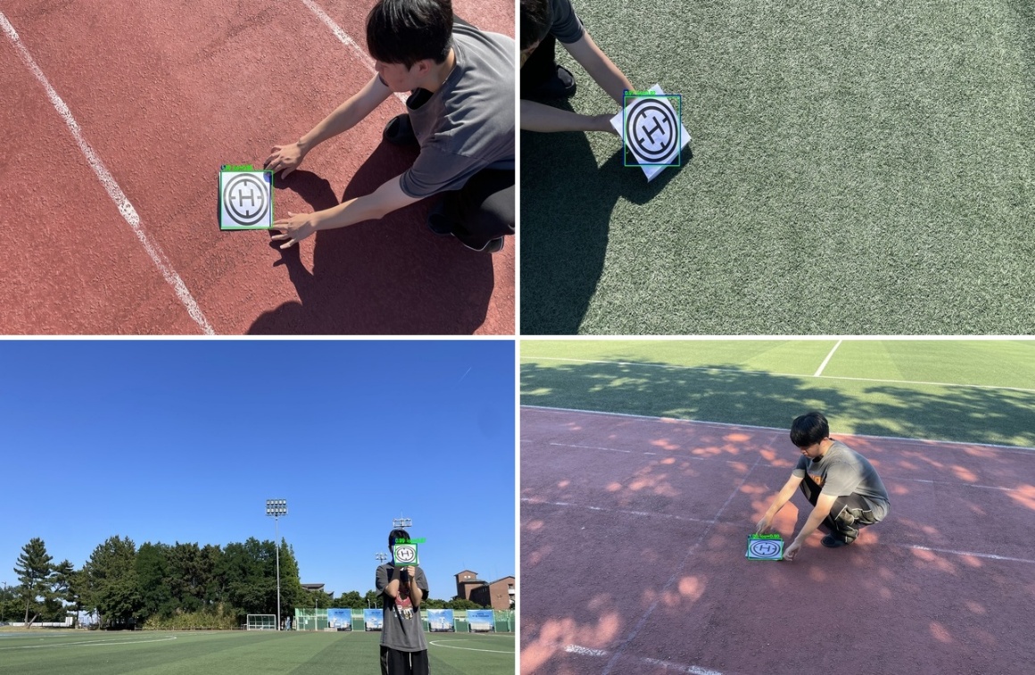
development-report/experiment-results/vision-landing/helipad_detection_examples.jpeg
