oldprize47-SH/AutonomousDrone/development-report/experiment-results/vision-landing/helipad_labeling_examples.png

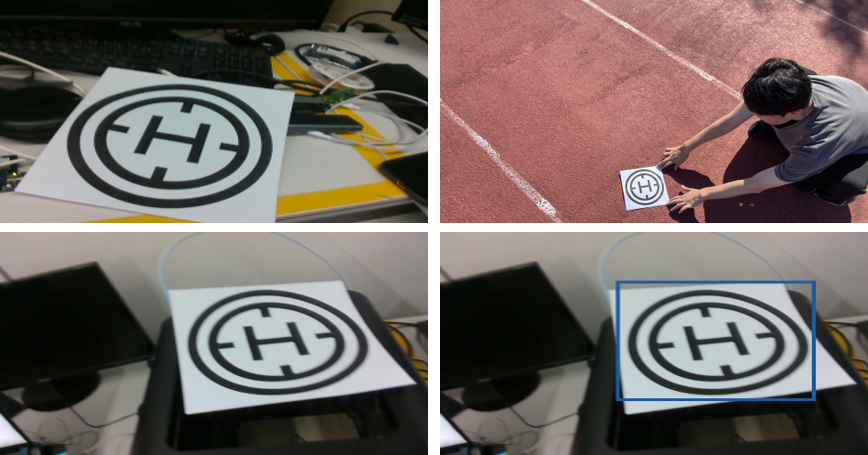
development-report/experiment-results/vision-landing/helipad_labeling_examples.png
