oldprize47-SH/AutonomousDrone/(commit log)

2026-07-05 Initial autonomous drone development archive
    [Final_mission_validation_summary.csv, Final_vision_landing_summary.csv]
2026-07-05 Reorganize experiment results by control topic
    [Final_mission_validation_summary.csv, Final_vision_landing_summary.csv]
